lcalona/CSE91-Robot/Millennium-Turkey.postroute.brd

## EAGLE design Millennium-Turkey.postroute.brd (2017-03-01)

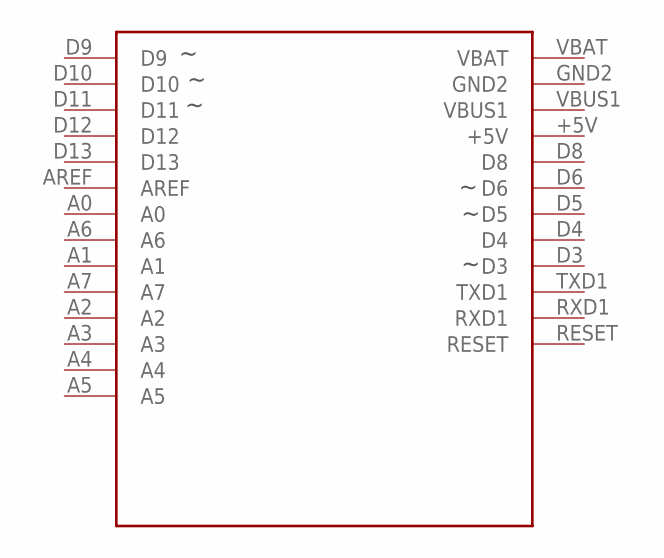
[picture p1: schematic Millennium-Turkey.postroute.sch, sheet 1]

Parts:
U3: ADAFRUIT-PRO-TRINKET-5V-NOFTDI

Connections:
+5V_0_BRAIN: U3.+5V; also elsewhere on the board
A0_0_BRAIN: U3.A0; also elsewhere on the board
A1_0_BRAIN: U3.A1
A2_0_BRAIN: U3.A2
A3_0_BRAIN: U3.A3
A4_0_BRAIN: U3.A4; also elsewhere on the board
A5_0_BRAIN: U3.A5; also elsewhere on the board
A6_0_BRAIN: U3.A6
A7_0_BRAIN: U3.A7
AREF_0_BRAIN: U3.AREF
D3_0_BRAIN: U3.D3; also elsewhere on the board
D4_0_BRAIN: U3.D4; also elsewhere on the board
D5_0_BRAIN: U3.D5; also elsewhere on the board
D6_0_BRAIN: U3.D6; also elsewhere on the board
D8_0_BRAIN: U3.D8; also elsewhere on the board
D9_0_BRAIN: U3.D9; also elsewhere on the board
D10_0_BRAIN: U3.D10; also elsewhere on the board
D11_0_BRAIN: U3.D11; also elsewhere on the board
D12_0_BRAIN: U3.D12; also elsewhere on the board
D13_0_BRAIN: U3.D13
GND_0_BRAIN: U3.GND2; also elsewhere on the board
POS_1_BATTERY: U3.VBAT; also elsewhere on the board
RESET_0_BRAIN: U3.RESET
RXD1_0_BRAIN: U3.RXD1
TXD1_0_BRAIN: U3.TXD1
VBUS1_0_BRAIN: U3.VBUS1

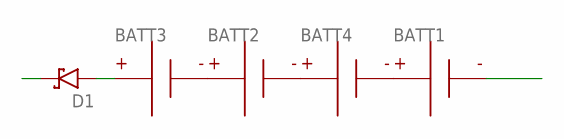
[picture p2: schematic Millennium-Turkey.postroute.sch, sheet 2]

Parts:
BATT1, BATT2, BATT3, BATT4: BATTERY-AA-CLIP; BATTERY-AA-BK-92
D1: RESOLVED-DIODE-SCHOTTKY_TH-DO-41-AND-DO-204AL; DIOAD1125W78L520D270_HS; MPN 1N5817

Connections:
GND_0_BRAIN: BATT1.N1 (N), BATT1.N2 (N); also elsewhere on the board
unnamed: BATT2.P1, BATT2.P2, BATT3.N1 (N), BATT3.N2 (N)
unnamed: BATT2.N1 (N), BATT2.N2 (N), BATT4.P1, BATT4.P2
unnamed: BATT1.P1, BATT1.P2, BATT4.N1 (N), BATT4.N2 (N)
unnamed: BATT3.P1, BATT3.P2, D1.A
POS_1_BATTERY: D1.C; also elsewhere on the board

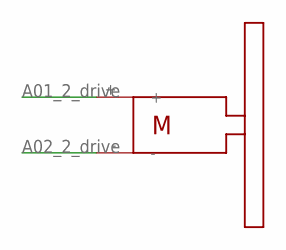
[picture p3: schematic Millennium-Turkey.postroute.sch, sheet 3]

Parts:
U2: SOLARBOTICS_GM2; SOLARBOTICS_G2

Connections:
A01_2_DRIVE: U2.+; also elsewhere on the board
A02_2_DRIVE: U2.-; also elsewhere on the board

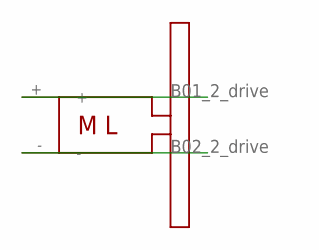
[picture p4: schematic Millennium-Turkey.postroute.sch, sheet 4]

Parts:
U4: SOLARBOTICS_GM2_LEFT; SOLARBOTICS_G2_LEFT

Connections:
B01_2_DRIVE: U4.+; also elsewhere on the board
B02_2_DRIVE: U4.-; also elsewhere on the board

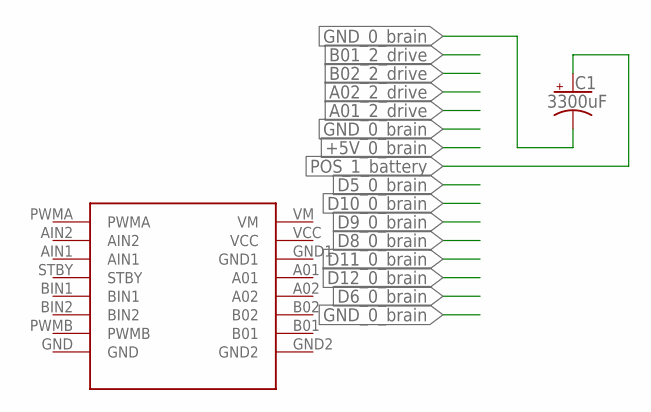
[picture p5: schematic Millennium-Turkey.postroute.sch, sheet 5]

Parts:
C1: 3300uF; CAPPRD750W80D1600H2200P; MPN ECA-1EM332
U1: SPARKFUN_DUAL_MOTOR_DRIVER-BOB; SPARKFUN_DUAL_MOTOR_DRIVER

Connections:
+5V_0_BRAIN: U1.VCC; also elsewhere on the board
A01_2_DRIVE: U1.A01; also elsewhere on the board
A02_2_DRIVE: U1.A02; also elsewhere on the board
B01_2_DRIVE: U1.B01; also elsewhere on the board
B02_2_DRIVE: U1.B02; also elsewhere on the board
D5_0_BRAIN: U1.PWMA; also elsewhere on the board
D6_0_BRAIN: U1.PWMB; also elsewhere on the board
D8_0_BRAIN: U1.STBY; also elsewhere on the board
D9_0_BRAIN: U1.AIN1; also elsewhere on the board
D10_0_BRAIN: U1.AIN2; also elsewhere on the board
D11_0_BRAIN: U1.BIN1; also elsewhere on the board
D12_0_BRAIN: U1.BIN2; also elsewhere on the board
GND_0_BRAIN: C1.2 (-), U1.GND, U1.GND1, U1.GND2; also elsewhere on the board
POS_1_BATTERY: C1.1 (+), U1.VM; also elsewhere on the board

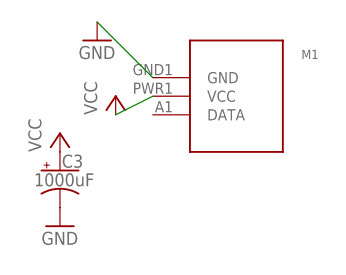
[picture p6: schematic Millennium-Turkey.postroute.sch, sheet 6]

Parts:
C3: 1000uF; CAPPRD500W80D1000H2200P; MPN ECA-1EM102
M1: SERVO-MICRO_SIDE_GLUE; SERVO_MICRO_SIDE_GLUE

Connections:
D3_0_BRAIN: M1.A1 (DATA); also elsewhere on the board
GND_0_BRAIN: C3.2 (-), M1.GND1 (GND); also elsewhere on the board
POS_1_BATTERY: C3.1 (+), M1.PWR1 (VCC); also elsewhere on the board

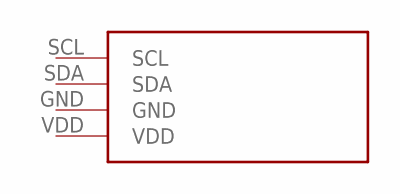
[picture p7: schematic Millennium-Turkey.postroute.sch, sheet 7]

Parts:
U6: ADAFRUIT-1.2IN-8X8-LED-BACKPACK-WHITE; ADAFRUIT-1.2IN-8X8-LED-BACKPACK

Connections:
+5V_0_BRAIN: U6.VDD; also elsewhere on the board
A4_0_BRAIN: U6.SDA; also elsewhere on the board
A5_0_BRAIN: U6.SCL; also elsewhere on the board
GND_0_BRAIN: U6.GND; also elsewhere on the board

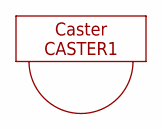
[picture p8: schematic Millennium-Turkey.postroute.sch, sheet 8]

Parts:
CASTER1: CASTERADAFRUIT-3/4IN; ADAFRUIT-3/4IN-CASTER

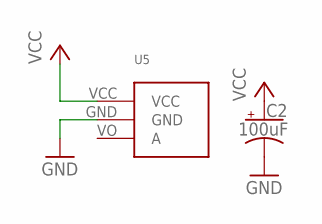
[picture p9: schematic Millennium-Turkey.postroute.sch, sheet 9]

Parts:
C2: 100uF; CAPPRD250W80D630H1220P; MPN ECA-1EM101
U5: ANALOG_DISTANCE_SENSOR-GLUE; ANALOG_DISTANCE_SENSOR_GLUE_MOUNT

Connections:
+5V_0_BRAIN: C2.1 (+), U5.VCC; also elsewhere on the board
A0_0_BRAIN: U5.VO (A); also elsewhere on the board
GND_0_BRAIN: C2.2 (-), U5.GND; also elsewhere on the board

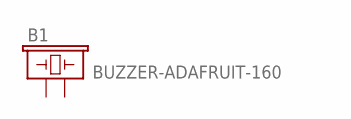
[picture p10: schematic Millennium-Turkey.postroute.sch, sheet 10]

Parts:
B1: BUZZER-ADAFRUIT-160; BUZZER-12MM-ADAFRUIT-160

Connections:
D4_0_BRAIN: B1.+ (1); also elsewhere on the board
GND_0_BRAIN: B1.- (2); also elsewhere on the board

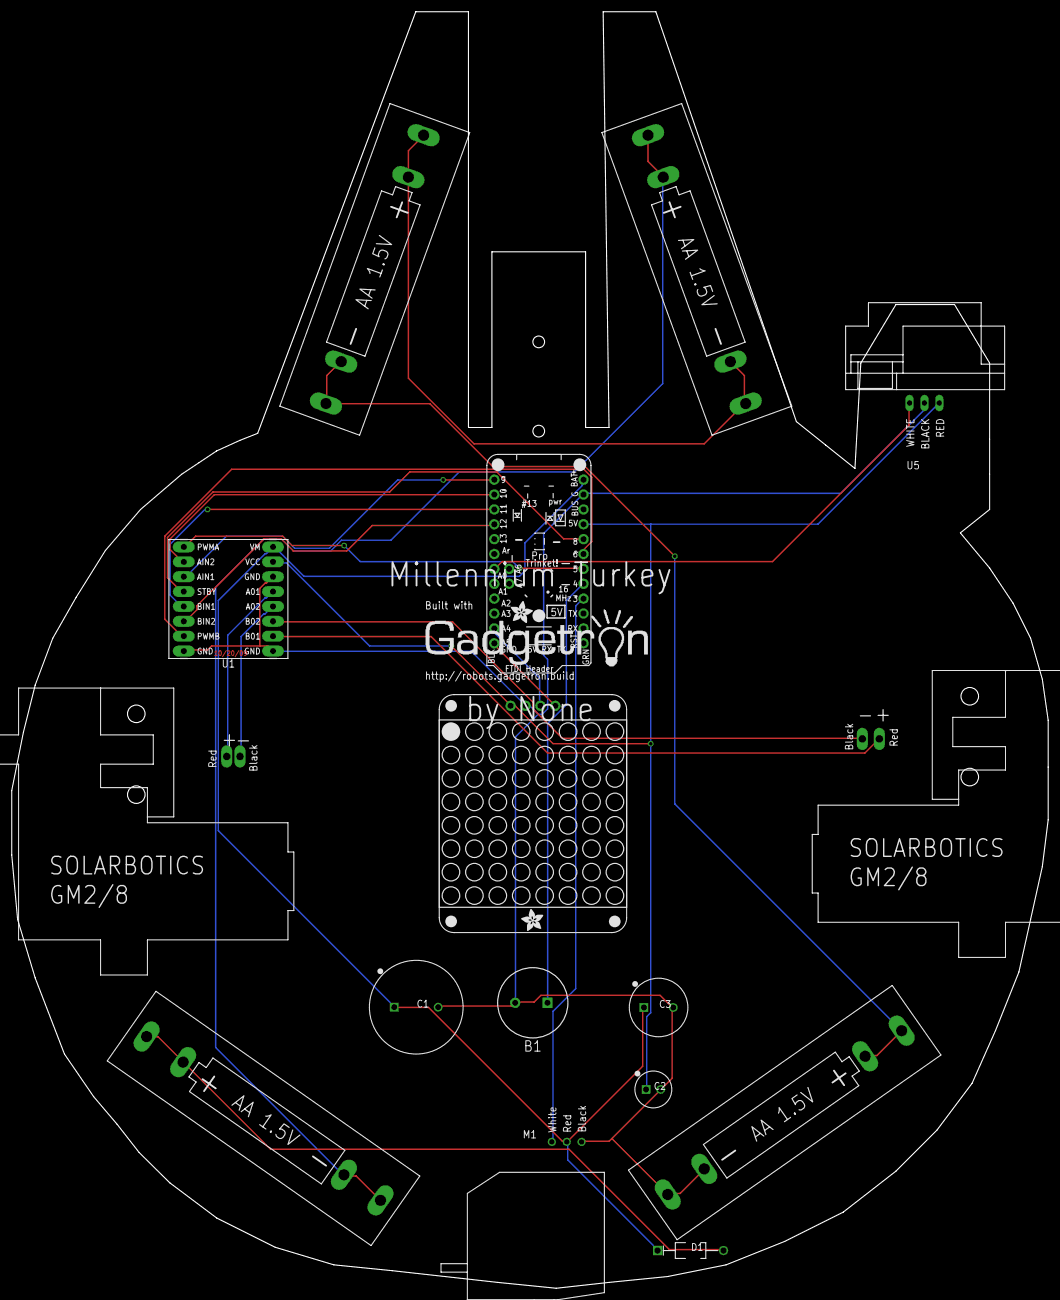
[picture p11: board Millennium-Turkey.postroute.brd from above]

Board: 2 copper layers, 177.0 x 218.0 mm, 18 parts (0 on the bottom side), 23 nets.

Other parts of the board:
LOGO: BUILT_WITH_GADGETRON
