lcalona/CSE91-Robot/Millennium-Turkey-assembly.html

# Assembly Instructions for Millennium Turkey

You are ready to build Millennium Turkey!

These instructions will guide you through the process of ordering the PCB for Millennium Turkey, ordering the parts, preparing them, assembling your robot, and then programming it.

- Part List
- Tools Required
- Ordering Your PCB
- Ordering 's Other Parts
- Prepare the Parts
- Assemble the PCB
- Final Assembly
- Programming
- Debugging and Common Problems

## Part List

(http://adafru.it/1200) Ball Caster - 3/4" Metal Ball $4.95 ; Adafruit part # 1200 Quantity required: 1

(http://adafru.it/160) Piezo Buzzer - PS1240 $1.5 ; Adafruit part # 160 Quantity required: 1

(http://adafru.it/1614) Small 1.2" 8x8 Ultra Bright White LED Matrix + Backpack $13.5 ; Adafruit part # 1614 Quantity required: 1

(http://adafru.it/2000) Adafruit Pro Trinket - 5V 16MHz $9.95 ; Adafruit part # 2000 Quantity required: 1

(http://www.digikey.com/product-search/en?keywords=3M9448-ND) CONN HEADER VERT SGL 3POS GOLD $0.26 ; Digikey part # 3M9448-ND Quantity required: 1

(http://www.digikey.com/product-search/en?keywords=497-4547-1-ND) DIODE SCHOTTKY 20V 1A DO41 $0.43 ; Digikey part # 497-4547-1-ND Quantity required: 1

(http://www.digikey.com/product-search/en?keywords=N145-ND) BATTERY ALKALINE 9V $2.38 ; Digikey part # N145-ND Quantity required: 1

(http://www.digikey.com/product-search/en?keywords=P5152-ND) CAP ALUM 100UF 20% 25V RADIAL $0.25 ; Digikey part # P5152-ND Quantity required: 1

(http://www.digikey.com/product-search/en?keywords=P5156-ND) CAP ALUM 1000UF 20% 25V RADIAL $0.68 ; Digikey part # P5156-ND Quantity required: 1

(http://www.digikey.com/product-search/en?keywords=P5158-ND) CAP ALUM 3300UF 20% 25V RADIAL $1.13 ; Digikey part # P5158-ND Quantity required: 1

(http://www.pololu.com/product/2450) Sharp GP2Y0A51SK0F Analog Distance Sensor 2-15cm $7.95 ; Pololu part # 2450 Quantity required: 1

(https://solarbotics.com/product/25500) HXT900 9g / 1.6kg / .12sec Micro Servo $5.85 ; SolarBotics part # 25500 Quantity required: 1

A geared motor suitable for driving the wheels of a robot.

$None ; None part # None Quantity required: 2

(https://solarbotics.com/product/gmpw) GM Series Plastic Wheels $3.25 ; Solarbotics part # gmpw Quantity required: 2

SparkFun Motor Driver - Dual TB6612FNG (1A) $None ; None part # None Quantity required: 1

(http://www.sparkfun.com/products/11301) SparkFun USB Mini-B Cable - 6 Foot $3.95 ; sparkfun part # 11301 Quantity required: 1

(http://www.sparkfun.com/products/9716) SparkFun FTDI Basic Breakout - 5V $14.95 ; sparkfun part # 9716 Quantity required: 1

## Tools Required

(https://learn.adafruit.com/lets-put-leds-in-things/tools)

Soldering irons vary widely in price and you need a few accessories to go with them (including solder!). Adafruit has a nice, short overview (https://learn.adafruit.com/lets-put-leds-in-things/tools) of what you'll need.

(https://www.adafruit.com/products/527)

A necessary tool for wiring up electronic components that don't attach to the PCB. There are many to choose from we like this one (https://www.adafruit.com/products/147) and this one. (https://www.adafruit.com/products/527)

(http://www.amazon.com/s/?field-keywords=hot+glue)

Hot glue is useful in all kinds of applications. It quick and holds things tightly. Keep some cool water near by, though, since you can get burned. You can buy them almost anywhere. Try Amazon (http://www.amazon.com/s/?field-keywords=hot+glue). Be sure to get some glue sticks as well.

(https://www.adafruit.com/products/424)

If you got screws, you gotta drive them. There are many options. The robot factory mostly uses small, phillips head screws, but check your parts list for what you'll need. These (https://www.adafruit.com/products/424) are nice.

## Ordering Your PCB

In order to build Millennium Turkey, you'll need to have it's circuit board manufactured. There are many services online that will do this for you, but they each require a slightly different set of design files. The robot factory produces PCB design files that are compatible with 4PCB.com's student program (http://www.4pcb.com/pcb-student-discount.html), an reasonably priced and, in our experience, reliable option. Below are instructions for ordering from 4PCB.com as well as general instructions for ordering from other services.

### Ordering Through 4PCB.com

To order through 4PCB, all you need is Millennium-Turkey.cam.zip. It contains the "gerber" files that specify everything about your PCB. You can find this file inside the zip file you downloaded after the Robot Factory was finished building your robot.

Here are the steps for ordering:

1. Visit http://www.4pcb.com/, and register for an account.
2. Return 4pcb.com and login.
3. Visit http://www.4pcb.com/pcb-prototype-2-4-layer-boards-specials.html, and select "Place Order" under "$33Each". A popup will appear, so be sure your pop-up blocker is turned off, if you have one.
4. Login to your account
5. Click "Choose file", and navigate to Millennium-Turkey.cam.zip.
6. Click "upload now"
7. Enter values for "Part #" and "Rev #". These can be whatever you want, but "Millennium Turkey" is a good choice.
8. Enter the size of your PCB in inches: Width = 6.97; Height = 8.58.
9. Make sure that "both side" is selected for "Soldermask" and "Silkscreen".
10. Enter the quantity you want to order. If you are elligible for the student program (http://www.4pcb.com/pcb-prototype-2-4-layer-boards-specials.html), you can enter any number here. If you aren't, 4PCB says you have to order at least three boards (It's not clear if they enforce this).
11. Select your shipping method. Shipping is pretty pricy, so consider using the slower, cheaper options.
12. Select "No" for "ITAR".
13. Enter your shipping and payment information
14. If you are elligible for the student program, enter "Student" in the comments field.
15. Click "Preview Order"
16. If everything looks good, submit it and wait. It takes 5 business days to build the board.

### Ordering Through Another Service

There are many other services besides 4PCB.com that will manufacture the PCB for Millennium Turkey (e.g., Seeed Studio's Fusion PCB (http://www.seeedstudio.com/fusion_pcb.html)). Many of them are cheaper, but we have also found them to be less reliable. Your miliage may vary.

Robot Factory does not provide design files for these other services, but it does provide Eagle design files for Millennium Turkey (Millennium-Turkey.postroute.sch and Millennium-Turkey.postroute.brd). You can use these (combined with a copy of Eagle's software) to generate the Gerbers that the service needs.

Doing this properly requires some expertise with Eagle, so if you haven't generated Gerbers in the past, you will need to find somen who can help you with the particular service you wish to use. Your local Makerspace is a good place to start.

## Ordering Millennium Turkey's Other Parts

The file contains the bill of materials for your robot. It contains a description of each part along with a distributor for it and the distributor's part number. Using that information, you can order everything you need for Millennium Turkey.

Some of the parts are optional, so you can skip them. However, the resulting robot may be less sturdy and harder to disassemble, making it more difficult to reuse some parts for other projects.

Please note that some items (e.g., screws and LEDs) come in "packs" that contain more than one item. The number of these "packs" (or individual items if they are sold singly) you will need is listed in the "Packs Required + Optional" and "Packs Required" columns.

Many of the parts for Millennium Turkey may also be available from other vendors and/or you may be able to find suitable substitutes.

## Prepare the Parts

The first stage in assembling Millennium Turkey is prepare the parts. This includes assembling and breakout board Millennium Turkey uses as well as assembly motors and other complex parts of Millennium Turkey that require extra work before attaching them to your PCB.

### Soldering Headers

Some of Millennium Turkey's components (like the micro controller) are breakout boards -- small circuit boards that you will attach to Millennium Turkey.

Breakout boards provide male headers that allow you to attach them to Millennium Turkey. If the headers are not already installed, you will need to solder them onto the breakout board.

If you haven't soldered before, don't worry: It is easy to learn, and assembling breakout boards is a good first project. Adafruit has an excellent tutorial on the subject. (https://learn.adafruit.com/adafruit-guide-excellent-soldering/tools)

The trick to attaching the headers is to make sure they are straight up and down. This ensure that your board looks good and that male and female headers will fit together nicely.

Here is our process for successful header soldering:

The video shows the steps for soldering male and female headers to breakout boards to Millennium Turkey's PCB.

1. Insert the header into the holes, and tape it place with masking tape.
2. Apply solder to one pin to hold the header in place.
3. Remove the tape, and check that the header is vertical.
4. If it is not, use your soldering iron to remelt the solder on the first pin so you can adjust its position.
5. Once you have it adjusted, apply solder to the other pins.

### Instructions for Individual Parts

## Assemble the PCB

Now, you will solder the components onto your PCB. If you are new to soldering, assembling Millennium Turkey is good practice. The Robot Factory designed Millennium Turkey to make it easy to solder.

If you need help, Adafruit has an excellent tutorial on the subject. (https://learn.adafruit.com/adafruit-guide-excellent-soldering/tools)

### Reference Designators

Reference designator

Reference designators like this identify parts on the PCB. Here, "C2" identifies a capacitor whose outline and mounting holes are also visible. Note that the pad ring around one of the holes is square rather than round. This primary pad for the part.

Each part on a PCB has short name -- called a reference designator -- that identifies it. Reference designators are usually a letter or short sequence of letters that denote the type of component followed by a unique number. For instance, C1 would be a capacitor while R4 is a resistor. The letter "U" is a catchall for miscelleneous part types.

All the parts you will be soldering are "through hole" parts, which mean that they make an electrical connection to the board via "pins" that go through the holes in the PCB. By applying solder to the pin, while it's in the hole, you will form the connection.

### Orienting Components

Example of identifying the primary pin on components with long leads

Some parts identify the primary lead by making it longer than the others.

For most parts, it is important that you put the correct pins into the correct holes. To help you, the "primary" hole for each part looks different from the others, because its pad ring (the small patch of metal surrounding the hole) is a different shape -- square instead of round. If one pin on the part is longer than the other, it is the "primary" pin and should go into the "primary" hole.

Some parts have special rules about how to determine which pin should go in which hole. The instructions below descibe them as needed.

### Soldering Components with Long Leads

The video shows the steps for soldering a part with long leads.

Many through-hole electrical components come with long wire leads attached to them. We recommend the following steps for soldering one of these components to your PCB:

1. Thread the leads through the holes from the front of the board (see the notes about orienting the component correctly above).
2. While holding the component in place with your finger, and with the back of the board facing you, bend the leads out to the side so they hold the part in place.
3. Apply solder on the back of the PCB where each lead comes through the board.
4. Trim the leads at the top of the solder joint.

### Installing Breakout Boards

In this stage you will install the breakout boards you assembled earlier. You have two options for attaching them to your PCB.

The first (and the one we provide instructions for below), uses female headers to allow you to temporarily attach the breakout board to your robot. This will let you reuse the breakout board in other projects (or on another robot).

In this case, you will solder the female headers to your board, and then plug the breakout board's male header into the female headers.

The second option is to solder the breakout board directly to your PCB. In this case, the breakout board will be more securely attach, and Millennium Turkey will look a little better. However, it is very difficult to remove the breakout board in this case (unless you have something like this (http://goo.gl/3s22HW)).

### Soldering Wires

The video shows the steps for soldering a wire to the PCB.

A few components require you to solder wires into holes on the PCB. Here are detailed instructions:

1. Begin by stripping 1cm or so of insulation off the wire using wire strippers.
2. If the wire is stranded (i.e., it's made up of many smaller wires), twist the exposed wires so they form a tight bundle.
3. Insert the tip of the wire through hole in the PCB, and apply solder from the opposite side of the board.
4. Trim off the excess wire.

### Instructions for Individual Parts

#### CAP ALUM 100UF 20% 25V RADIAL (http://www.digikey.com/product-search/en?keywords=P5152-ND)

1. Your design contains 1 of these parts. Their locations on the board are labeled with the following reference designator(s):
  - C2

For each of them, do the following:

  1. Find the location for this part on the board by matching up the outline and the name.
  2. Orient the capacitor correctly: The longer pin goes into the hole surrounded by a square copper "ring."
  3. Thread the capacitor's leads through the holes in the PCB.
  4. Bend the leads to the side on back of the board to hold capacitor in position.
  5. Apply solder to the leads from the back.
  6. Trim the excess from the wire leads.

#### SparkFun Motor Driver - Dual TB6612FNG (1A)

2. You will need the following parts:

  (http://www.digikey.com/product-search/en?keywords=S7006-ND) 8 Position Header Connector 0.100" (2.54mm) Through Hole Tin
  Your design contains 1 of these parts. Their locations on the board are labeled with the following reference designator(s):
  - U1

For each of them, do the following:

  1. Find the outline of the motor driver on the PCB.
  2. If you are using the optional female mounting header, solder to them PCB, and insert the male headers into them to install the controller.
  3. Otherwise, insert the headers through holes in the PCB, and solder them in place.

#### Sharp GP2Y0A51SK0F Analog Distance Sensor 2-15cm (http://www.pololu.com/product/2450)

3. You will need the following parts:

  (http://www.pololu.com/product/2411) 3-Pin Female JST ZH-Style Cable (30cm) for Sharp GP2Y0A51 Distance Sensors
  Your design contains 1 of these parts. Their locations on the board are labeled with the following reference designator(s):
  - U5

For each of them, do the following:

  1. Find the location for this part on the board by matching up the outline and the name.
  2. Insert the wires into the three holes next to the motion sensor, matching them by color.
  3. Solder the wires in place from the back.
  4. Use a very small quantity (maybe 1mm in diameter) of hot glue to attach the sensor to the board.

#### Small 1.2" 8x8 Ultra Bright White LED Matrix + Backpack (http://adafru.it/1614)

4. You will need the following parts:

  (http://www.digikey.com/product-search/en?keywords=S7002-ND) 4 Position Header Connector 0.100" (2.54mm) Through Hole Tin
  Your design contains 1 of these parts. Their locations on the board are labeled with the following reference designator(s):
  - U6

For each of them, do the following:

  1. Find the location of for this LED array.
  2. Insert the female header into the four holes.
  3. Apply solder to the pins on the back of the PCB.

#### Side Micro Servo

5. You will need the following parts:
  (http://www.digikey.com/product-search/en?keywords=3M9448-ND) CONN HEADER VERT SGL 3POS GOLD
  Your design contains 1 of these parts. Their locations on the board are labeled with the following reference designator(s):
  - M1

For each of them, do the following:

  1. Find the location for this part on the board by matching up the outline and the name.
  2. Locate the outline of the servo on the PCB.
  3. Solder the three-pin header into the three holes next to the gripper's location.

#### DIODE SCHOTTKY 20V 1A DO41 (http://www.digikey.com/product-search/en?keywords=497-4547-1-ND)

6. Your design contains 1 of these parts. Their locations on the board are labeled with the following reference designator(s):
  - D1

For each of them, do the following:

  1. Find the location for this part on your PCB by matching up the outline and name. Check the orientation carefully (see the notes about orienting the component correctly above). If you install the diode backward, your robot will not work properly.
  2. Solder it there

#### Adafruit Pro Trinket - 5V 16MHz (http://adafru.it/2000)

7. You will need the following parts:

  (http://www.digikey.com/product-search/en?keywords=S6100-ND) 12 Position Header Connector 0.100" (2.54mm) Through Hole Tin
  Your design contains 1 of these parts. Their locations on the board are labeled with the following reference designator(s):
  - U3

For each of them, do the following:

  1. Find the matching outline of the trinket on your robot's PCB.
  2. Solder the female headers into the two sets of holes.

#### CAP ALUM 1000UF 20% 25V RADIAL (http://www.digikey.com/product-search/en?keywords=P5156-ND)

8. Your design contains 1 of these parts. Their locations on the board are labeled with the following reference designator(s):
  - C3

For each of them, do the following:

  1. Find the location for this part on the board by matching up the outline and the name.
  2. Orient the capacitor correctly: The longer pin goes into the hole surrounded by a square copper "ring."
  3. Thread the capacitor's leads through the holes in the PCB.
  4. Bend the leads to the side on back of the board to hold capacitor in position.
  5. Apply solder to the leads from the back.
  6. Trim the excess from the wire leads.

#### Piezo Buzzer - PS1240 (http://adafru.it/160)

9. Your design contains 1 of these parts. Their locations on the board are labeled with the following reference designator(s):
  - B1

For each of them, do the following:

  1. Find the location for this part on the board by matching up the outline and the name.
  2. Thread the leads through the holes in the PCB. It doesn't matter which lead goes in which hole.
  3. Solder the leads into place from the back.
  4. Trim the excess from the wire leads.

#### CAP ALUM 3300UF 20% 25V RADIAL (http://www.digikey.com/product-search/en?keywords=P5158-ND)

10. Your design contains 1 of these parts. Their locations on the board are labeled with the following reference designator(s):
  - C1

For each of them, do the following:

  1. Find the location for this part on the board by matching up the outline and the name.
  2. Orient the capacitor correctly: The longer pin goes into the hole surrounded by a square copper "ring."
  3. Thread the capacitor's leads through the holes in the PCB.
  4. Bend the leads to the side on back of the board to hold capacitor in position.
  5. Apply solder to the leads from the back.
  6. Trim the excess from the wire leads.

## Final Assembly

Now that everything is prepared you are ready to assemble Millennium Turkey! Follow the steps below.

#### Analog Distance Sensor 2-15cm (https://www.pololu.com/product/2450)

1. Use the steps below to assemble this part.
  1. Use a dab of hot glue to attach distance sensor to the board

#### Servo (https://solarbotics.com/product/25500/)

2. Use the steps below to assemble this part.
  1. Glue the servo in place using a dab of hot glue.
  2. Plug in the servo by attaching the 3-conductor wire to the 3-pin header. Align the pins according to their color.

#### Small 1.2" 8x8 Ultra Bright White LED Matrix + Backpack (http://adafru.it/1614)

3. Use the steps below to assemble this part.
  1. Insert the four pins on the array into the female headers.

#### Battery

4. Use the steps below to assemble this part.
  1. Check that the batteries fits, but don't install them until the rest of the robot is assembled.

#### Ball Caster

5. Use the steps below to assemble this part.
  1. Locate the outline of the caster on your PCB.
  2. Use the screws and nuts included with the caster to attach it to the bottom of the PCB. The ball should be underneath the PCB.

#### Fast, narrow drive wheels

6. Use the steps below to assemble this part.
  1. Attach the wheels by pressing them onto the motor shafts.

#### Adafruit Pro Trinket - 5V 16MHz (http://adafru.it/2000)

7. Use the steps below to assemble this part.
  1. Insert the headers on the Pro Trinket into the headers on the PCB.

#### Ball Caster - 3/4" Metal Ball (http://adafru.it/1200)

8. Use the steps below to assemble this part.
  1. Locate the outline for the caster on the underside of the PCB.
  2. Insert the thin bolts through the PCB and secure it with with small bolts.

## Programming

Millennium Turkey is based on an Arduino (https://www.arduino.cc/) microcontroller (in particular, the Adafruit Pro Trinket (https://www.adafruit.com/product/2000)), and you can program it using your computer. Follow the directions below to get started.

### Installing Arduino

Visit the Arduino Downloads page (https://www.arduino.cc/en/Main/Software) to download the latest version of the Arduino integrated development environment (IDE). Follow the instruction on the site for installing it.

### Getting Started With the Pro Trinket and Connecting to

If you haven't used an Arduino before, it'll be easier if you familiarize yourself with it first before programming Millennium Turkey. Adafruit has an excellent tutorial on getting started with the Pro Trinket (https://learn.adafruit.com/introducing-pro-trinket). You can remove your Pro Trinket from Millennium Turkey and go through the tutorial.

One note: There are two ways to program a Pro Trinket (and, therefore, Millennium Turkey): Using USB directly or using an FTDI adapter. We recommend using the FTDI adapter. To do so, follow the instructions here (https://learn.adafruit.com/introducing-pro-trinket/using-ftdi).

### Installing the Gadgetron Libraries

The Gadgetron libraries contains all the Arduino libraries needed to interact with the breakout boards and parts available in the Robot Factory software.

To install the Gadgetron Libraries first open your Arduino IDE and navigate to Sketch -> Include Library -> Manage Libraries... . After that a popup window will open with a list of Arduino libraries you can install. Search there for Gadgetron Libraries and install this library.

Now the Gadgetron Libraries should be installed and ready to use.

If you have problems finding the library you can manually install the library by following the next steps.

First download the following zip file ( gadgetron-software-libraries-1.0.0.zip (https://github.com/NVSL/gadgetron-software-libraries/archive/1.0.0.zip)). After downloading the zip file open your Arduino IDE and go to Sketch -> Include Library -> Add .ZIP Library . Finally select the zip file you just downloaded to install the Gadgetron Libraries.

### Running Millennium Turkey's Sample Code

The zip file tha contains these instructions also contains a file called Millennium-Turkey.ino. It contains a simple program that will test all the parts of Millennium Turkey. Open it from inside the Arduino IDE.

Open the file in the Arduino IDE. Then, configure Arduino IDE to work with the Pro Trinket: Select "Tools->Board->Pro Trinket 5V/16MHz (FTDI)". Then, select "Tool->Programmer->USBTinyISP".

Plug in the USB cable to your computer and attach the "SparkFun FTDI Basic Breakout - 5V" to the USB cable. Then select "Tools->Port" a list of serial ports will appear the correct option to choose will vary depending on your computer.:

- On a Mac it will be something like /dev/tty.usbserial-A02f8e. The options with "bluetooth" or "wireless" in the names will not work. If you don't see a "usbserial" option, try unplugging the USB cable and plugging it back in and/or restart the IDE.
- On a PC, there will be one or more options that look like COM<N<. The correct choice is usually the one with the highest number.

You may need to experiment some with the settings. If you are having trouble, remove the Pro Trinket from your robot, and follow the documentation here (https://learn.adafruit.com/introducing-pro-trinket/using-ftdi). It will help troubleshoot any problems and should let you get a simple program running on the Pro Trinket.

Once you have Arduino configured, you should be able to compile and download the program to Millennium Turkey. Once it's running, it should briefly activate each of the components on Millennium Turkey (e.g., the wheels will turn briefly, the LEDs will flash).

If you assembled Millennium Turkey correctly, everything should work fine.

If it doesn't here are some things to check for:

- Make sure your battery is fresh.
- Make sure all your breakout boards are installed properly (e.g., that Pro Trinket is not installed backward).

### Additional Examples and Documentation

Once you've confirmed that all the parts of Millennium Turkey work as expected, you can start programming it to do what you want!

You can find additional example code for each of the component by selecting "File->Examples" and choosing the component you would like to learn more about.

Additional documentation is available for the components on Millennium Turkey as well:

- Analog Distance Sensor 2-15cm (http://test-dot-ucsdgadgetron.appspot.com/component/analog_distance_sensor/docs).
- Servo (http://test-dot-ucsdgadgetron.appspot.com/component/servo-normal-side/docs).
- Battery (http://test-dot-ucsdgadgetron.appspot.com/component/battery-4xAA/docs).
- Ball Caster (http://test-dot-ucsdgadgetron.appspot.com/component/ball-caster-0.75in/docs).
- Fast, narrow drive wheels (http://test-dot-ucsdgadgetron.appspot.com/component/dual-motor-kit-narrow-fast/docs).
- Adafruit Pro Trinket - 5V 16MHz (http://test-dot-ucsdgadgetron.appspot.com/component/Adafruit-Pro-Trinket-5V-battery-powered-6V/docs).
- 1.2" 8x8 LED Matrix, white (http://test-dot-ucsdgadgetron.appspot.com/component/Adafruit-8x8-1.2in-led-array-white/docs).
- A simple buzzer (http://test-dot-ucsdgadgetron.appspot.com/component/piezo-buzzer-variable/docs).

## Debugging and Common Problems

If the battery is powering a microcontroller and the microcontroller resets frequently, that is a good sign that the battery is dying and needs to be replaced.
